chenzhjie/F1C200S-HomeAssistant-Board/README.md

# F1C200S-HomeAssistant-Board

这是一个 F1C200S 的 Linux 开发板。
