chenzhjie/F1C200S-HomeAssistant-Board/F1C200S-HomeAssistant-Board/case/top.STEP

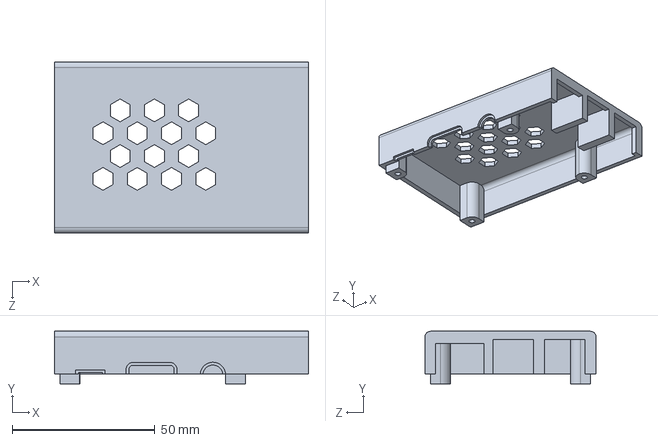
[picture p1: CAD file, 2022-08-28]
F1C200S-HomeAssistant-Board/case/top.STEP
89.0 x 18.4 x 60.0 mm
