chenzhjie/F1C200S-HomeAssistant-Board/F1C200S-HomeAssistant-Board/model/USB_type_C_smd.stp

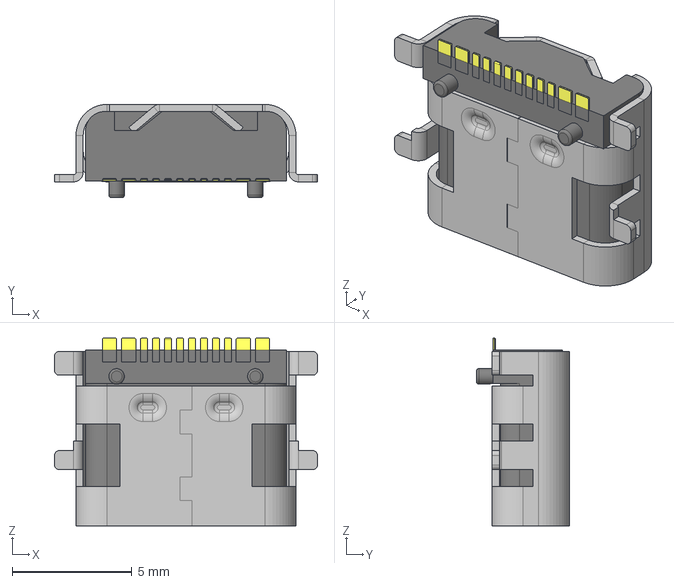
[picture p2: CAD file, 2022-08-28]
F1C200S-HomeAssistant-Board/model/USB_type_C_smd.stp
11.0 x 3.90 x 7.85 mm
