chenzhjie/F1C200S-HomeAssistant-Board/F1C200S-HomeAssistant-Board/case/bottom.STEP

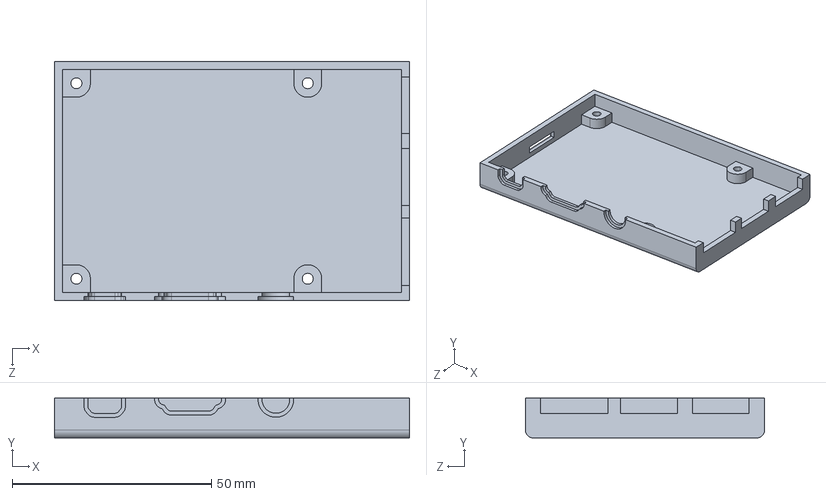
[picture p3: CAD file, 2022-08-28]
F1C200S-HomeAssistant-Board/case/bottom.STEP
89.0 x 10.0 x 60.0 mm
