chenzhjie/F1C200S-HomeAssistant-Board/F1C200S-HomeAssistant-Board/F1C200S-HomeAssistant-Board.kicad_pcb

## KiCad design F1C200S-HomeAssistant-Board/F1C200S-HomeAssistant-Board.kicad_pcb (2022-09-03)

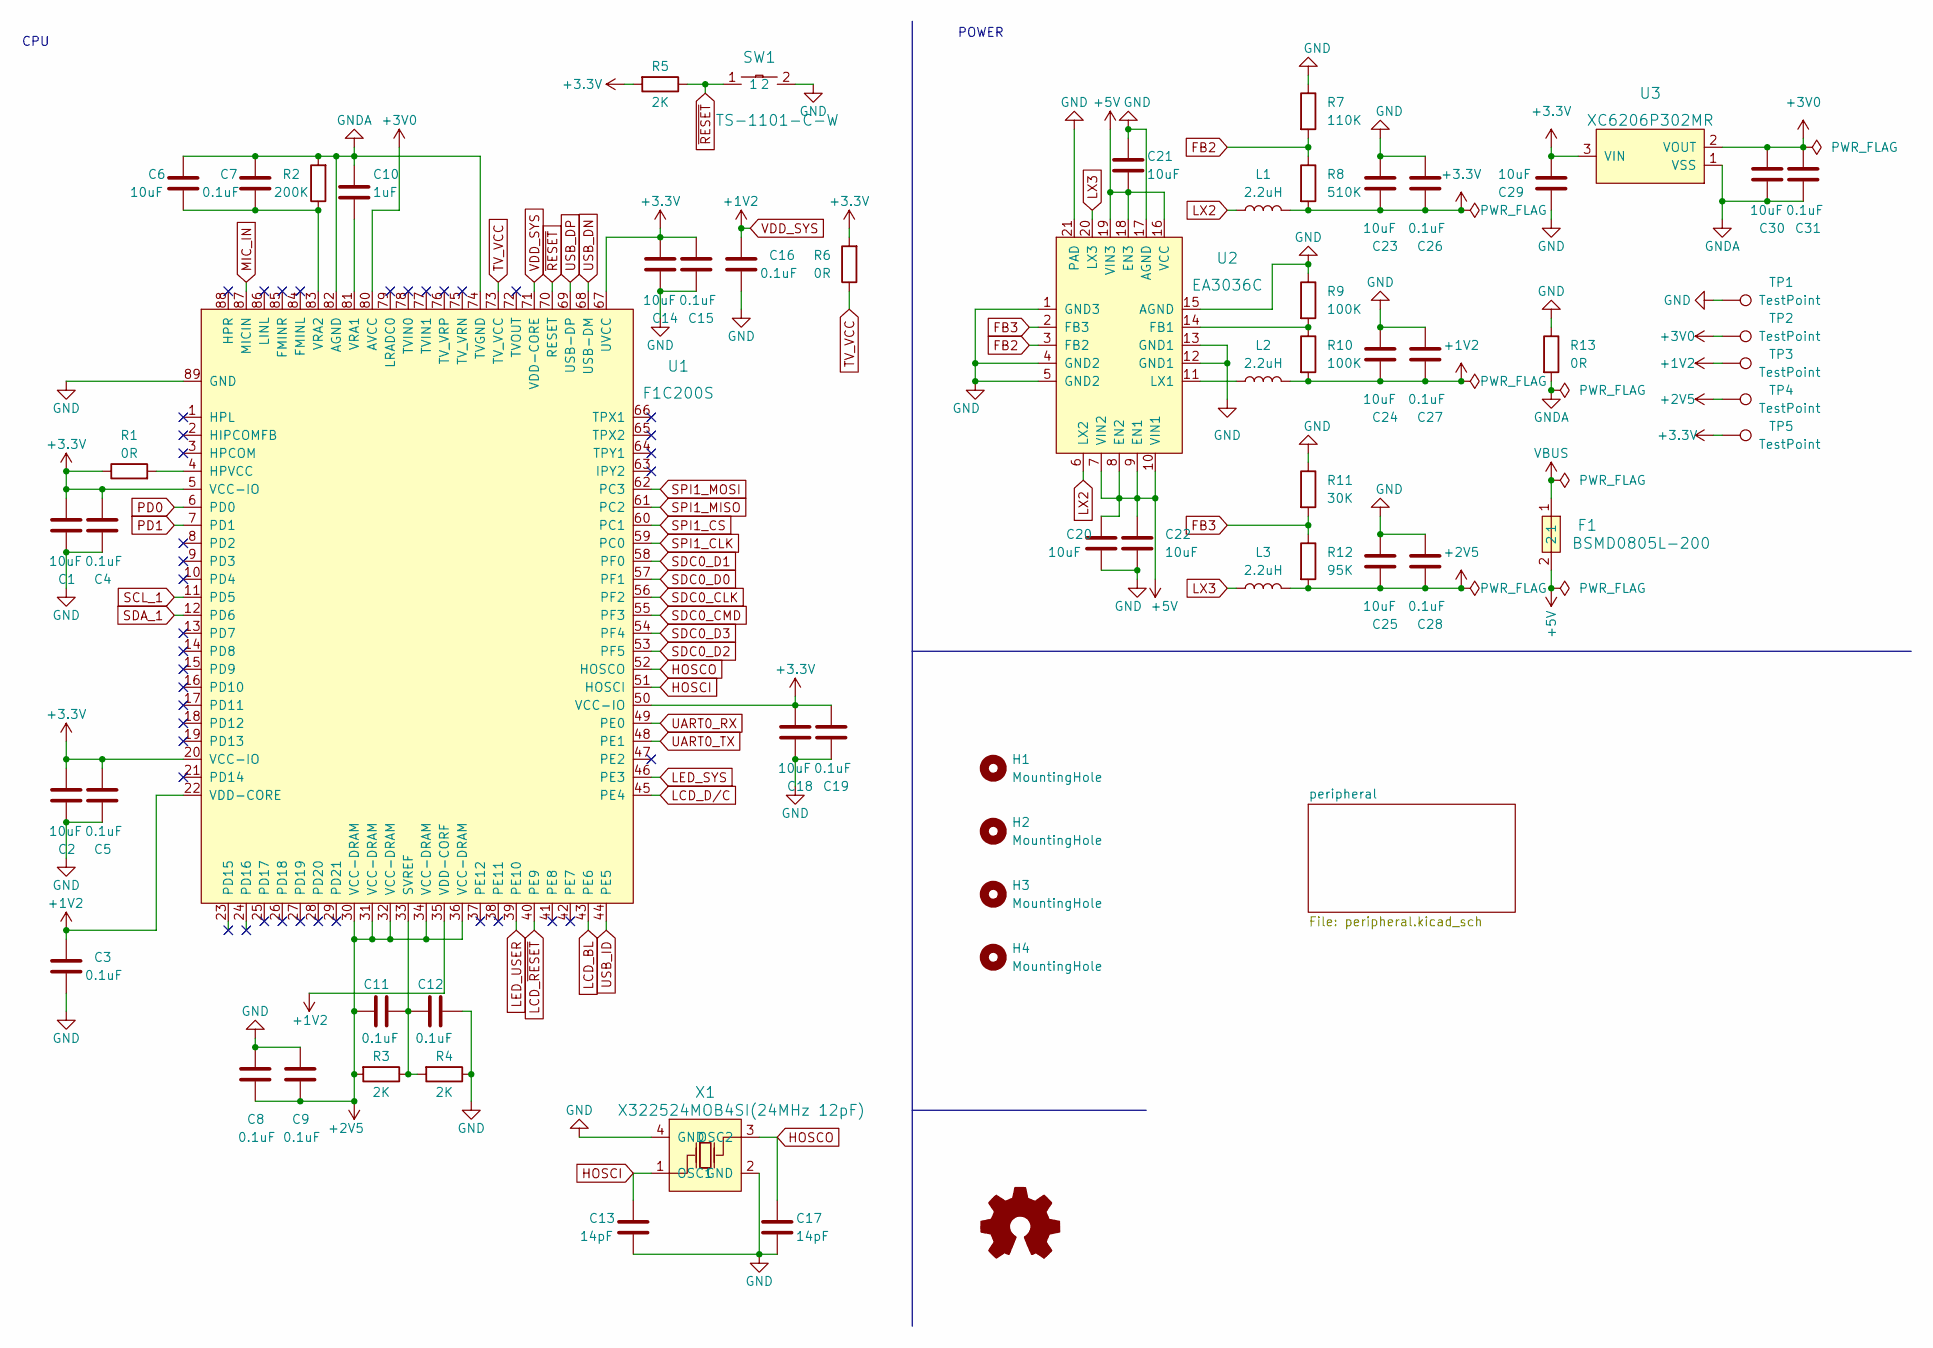
[picture p4: schematic F1C200S-HomeAssistant-Board.kicad_sch]

Parts:
C1, C2, C6, C14, C18, C20, C21, C22, C23, C24, C25, C29, C30: 10uF; C_0402_1005Metric_Pad0.74x0.62mm_HandSolder; LCSC Part C15525
C3, C4, C5, C7, C8, C9, C11, C12, C15, C16, C19, C26, C27, C28, C31: 0.1uF; C_0402_1005Metric_Pad0.74x0.62mm_HandSolder; LCSC Part C60474
C10: 1uF; C_0402_1005Metric_Pad0.74x0.62mm_HandSolder; LCSC Part C107372
C13, C17: 14pF; C_0402_1005Metric_Pad0.74x0.62mm_HandSolder; LCSC Part C3037644
F1: BSMD0805L-200; F0805; LCSC Part C2757931
H1, H2, H3, H4: MountingHole; MountingHole_2.7mm_M2.5
L1, L2, L3: 2.2uH; L0603; LCSC Part C394950
R1, R6, R13: 0R; R_0402_1005Metric_Pad0.72x0.64mm_HandSolder; LCSC Part C21376
R2: 200K; R_0402_1005Metric_Pad0.72x0.64mm_HandSolder; LCSC Part C114763
R3, R4, R5: 2K; R_0402_1005Metric_Pad0.72x0.64mm_HandSolder; LCSC Part C60488
R7: 110K; R_0402_1005Metric_Pad0.72x0.64mm_HandSolder; LCSC Part C138065
R8: 510K; R_0402_1005Metric_Pad0.72x0.64mm_HandSolder; LCSC Part C137961
R9, R10: 100K; R_0402_1005Metric_Pad0.72x0.64mm_HandSolder; LCSC Part C60491
R11: 30K; R_0402_1005Metric_Pad0.72x0.64mm_HandSolder; LCSC Part C138008
R12: 95K; R_0402_1005Metric_Pad0.72x0.64mm_HandSolder
SW1: TS-1101-C-W; SW-SMD_L6.0-W3.3-LS8.0; LCSC Part C318938
TP1, TP2, TP3, TP4, TP5: TestPoint; TestPoint_Pad_D1.0mm
U1: F1C200S; QFN-88_L10.0-W10.0-P0.40-BL-EP6.75; LCSC Part C2879851
U2: EA3036C; WQFN-20_L3.0-W3.0-P0.40-BL-EP; LCSC Part C570857
U3: XC6206P302MR; SOT-23-3L_L2.9-W1.6-P1.90-LS2.8-BL; LCSC Part C2904833
X1: X322524MOB4SI(24MHz 12pF); CRYSTAL-SMD_4P-L3.2-W2.5-BL; LCSC Part C70590

Connections:
+2V5: C8.2, C9.2, C11.1, C25.2, C28.2, L3.2, R3.2, R12.2, TP4.1, U1.30 (VCC-DRAM), U1.31 (VCC-DRAM), U1.32 (VCC-DRAM), U1.34 (VCC-DRAM), U1.36 (VCC-DRAM)
+3V0: C30.1, C31.1, TP2.1, U1.80 (AVCC), U3.2 (VOUT); also elsewhere on the board
+5V: C20.1, C21.1, C22.1, F1.2, U2.7 (VIN2), U2.8 (EN2), U2.9 (EN1), U2.10 (VIN1), U2.16 (VCC), U2.18 (EN3), U2.19 (VIN3); also elsewhere on the board
FB2: R7.2, R8.1, U2.3 (FB2)
FB3: R11.2, R12.1, U2.2 (FB3)
GND: C1.2, C2.2, C3.2, C4.2, C5.2, C8.1, C9.1, C12.2, C13.2, C14.2, C15.2, C16.2, C17.2, C18.2, C19.2, C20.2, C21.2, C22.2, C23.1, C24.1, C25.1, C26.1, C27.1, C28.1, C29.2, R4.1, R7.1, R9.1, R11.1, R13.1, SW1.2, TP1.1, U1.89 (GND), U2.1 (GND3), U2.4 (GND2), U2.5 (GND2), U2.12 (GND1), U2.13 (GND1), U2.15 (AGND), U2.17 (AGND), U2.21 (PAD), X1.2 (GND), X1.4 (GND); also elsewhere on the board
GNDA: C6.1, C7.1, C10.1, C30.2, C31.2, R2.2, R13.2, U1.74 (TVGND), U1.82 (AGND), U3.1 (VSS); also elsewhere on the board
HOSCI: C13.1, U1.51 (HOSCI), X1.1 (OSC1)
HOSCO: C17.1, U1.52 (HOSCO), X1.3 (OSC2)
LCD_BL: U1.43 (PE6); also elsewhere on the board
LCD_D/C: U1.45 (PE4); also elsewhere on the board
LCD_~RESET: U1.40 (PE9); also elsewhere on the board
LED_SYS: U1.46 (PE3); also elsewhere on the board
LED_USER: U1.39 (PE10); also elsewhere on the board
LX2: L1.1, U2.6 (LX2)
LX3: L3.1, U2.20 (LX3)
MIC_IN: U1.87 (MICIN); also elsewhere on the board
unnamed: C6.2, C7.2, R2.1, U1.83 (VRA2)
unnamed: C10.2, U1.81 (VRA1)
unnamed: C11.2, C12.1, R3.1, R4.2, U1.33 (SVREF)
unnamed: L2.1, U2.11 (LX1)
unnamed: R1.2, U1.4 (HPVCC)
unnamed: R9.2, R10.1, U2.14 (FB1)
PD0: U1.6 (PD0); also elsewhere on the board
PD1: U1.7 (PD1); also elsewhere on the board
SCL_1: U1.11 (PD5); also elsewhere on the board
SDA_1: U1.12 (PD6); also elsewhere on the board
SDC0_CLK: U1.56 (PF2); also elsewhere on the board
SDC0_CMD: U1.55 (PF3); also elsewhere on the board
SDC0_D0: U1.57 (PF1); also elsewhere on the board
SDC0_D1: U1.58 (PF0); also elsewhere on the board
SDC0_D2: U1.53 (PF5); also elsewhere on the board
SDC0_D3: U1.54 (PF4); also elsewhere on the board
SPI1_CLK: U1.59 (PC0); also elsewhere on the board
SPI1_CS: U1.60 (PC1); also elsewhere on the board
SPI1_MISO: U1.61 (PC2); also elsewhere on the board
SPI1_MOSI: U1.62 (PC3); also elsewhere on the board
TV_VCC: R6.1, U1.73 (TV_VCC)
UART0_RX: U1.49 (PE0); also elsewhere on the board
UART0_TX: U1.48 (PE1); also elsewhere on the board
USB_DN: U1.68 (USB-DM); also elsewhere on the board
USB_DP: U1.69 (USB-DP); also elsewhere on the board
USB_ID: U1.44 (PE5); also elsewhere on the board
VBUS: F1.1; also elsewhere on the board
VDD_SYS: C3.1, C16.1, C24.2, C27.2, L2.2, R10.2, TP3.1, U1.22 (VDD-CORE), U1.35 (VDD-CORF), U1.71 (VDD-CORE)
~RESET: R5.1, SW1.1, U1.70 (RESET)

Notes on the sheet:
POWER
CPU

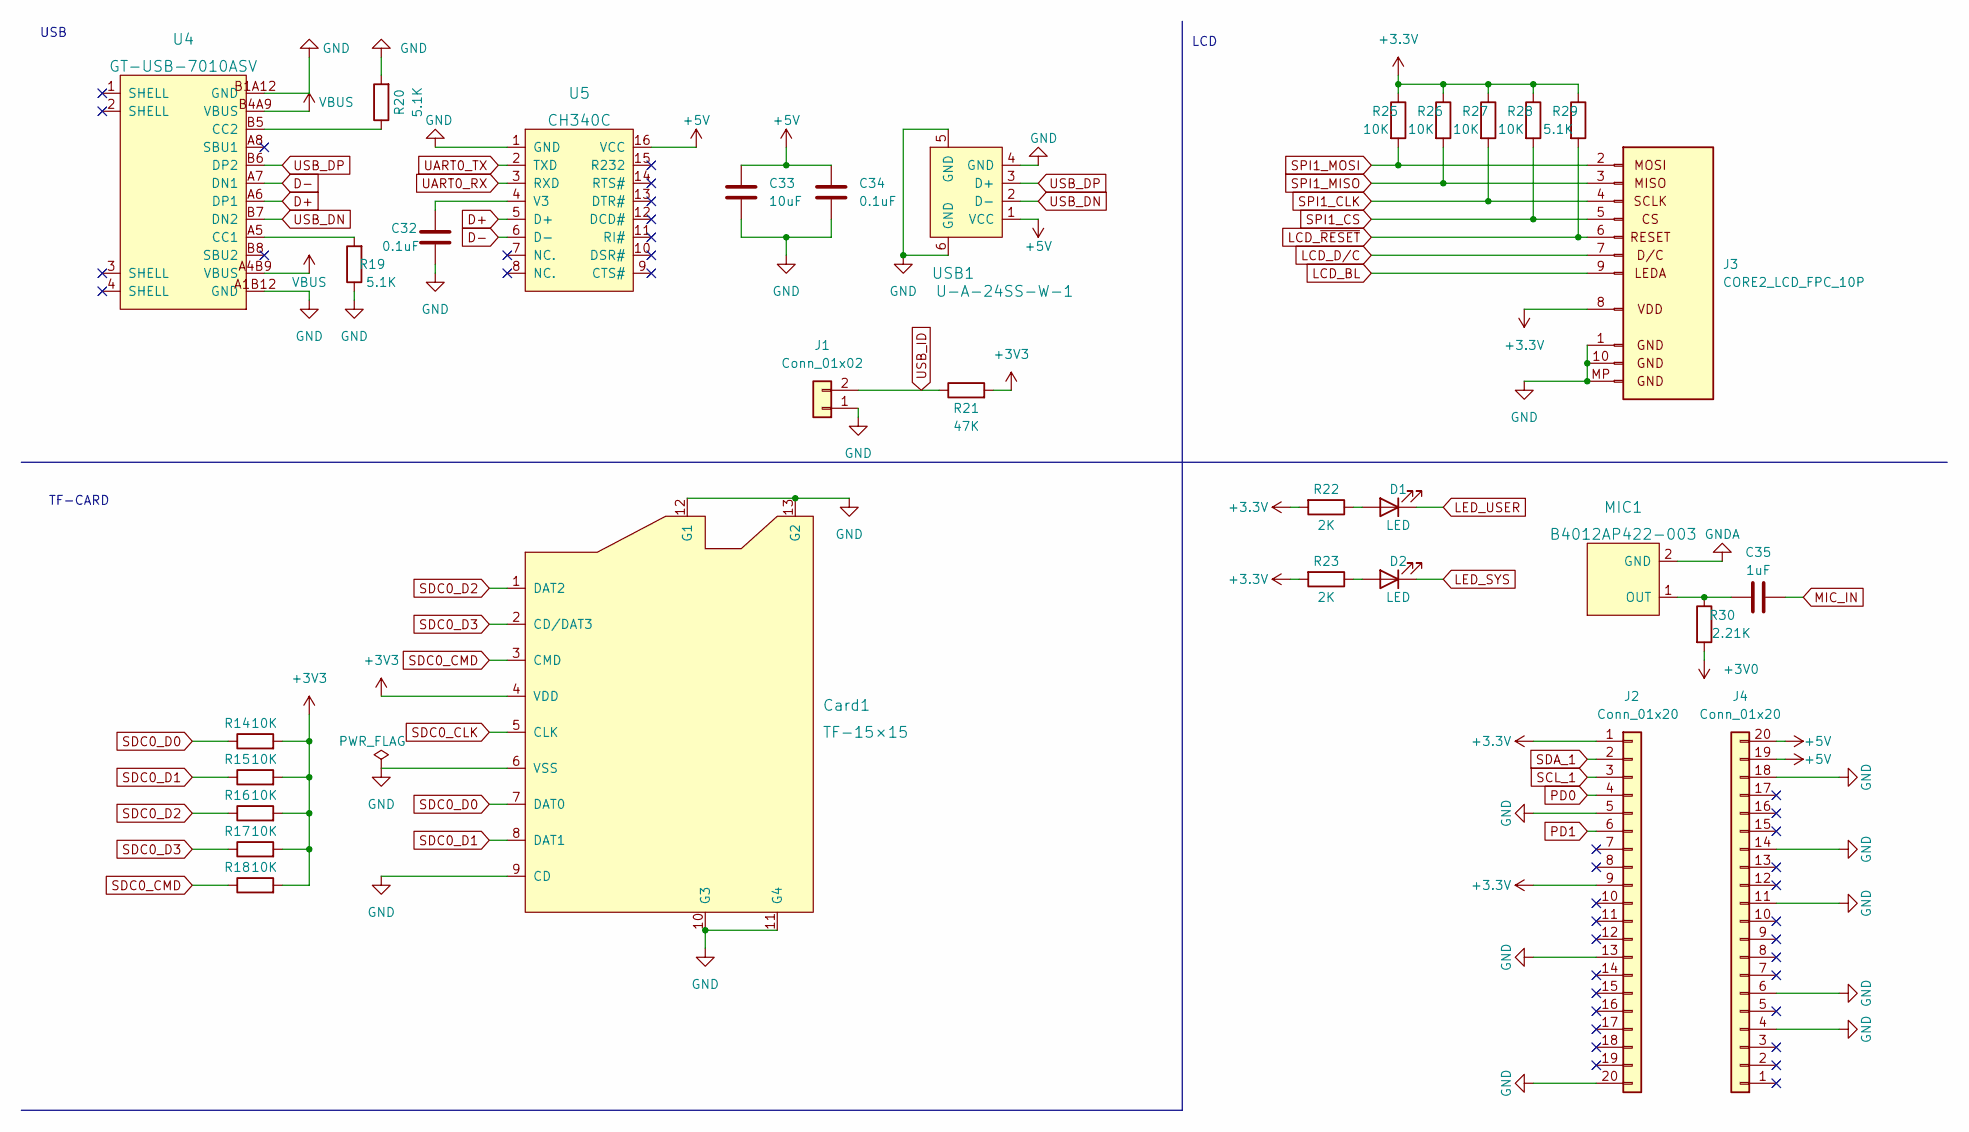
[picture p5: schematic peripheral.kicad_sch]

Parts:
C32, C34: 0.1uF; C_0402_1005Metric_Pad0.74x0.62mm_HandSolder; LCSC Part C60474
C33: 10uF; C_0402_1005Metric_Pad0.74x0.62mm_HandSolder; LCSC Part C15525
C35: 1uF; C_0402_1005Metric_Pad0.74x0.62mm_HandSolder; LCSC Part C107372
Card1: TF-15×15; TF-SMD_TF-15-15; LCSC Part C111196
D1: LED; LED_0402_1005Metric_Pad0.77x0.64mm_HandSolder; LCSC Part C434446
D2: LED; LED_0402_1005Metric_Pad0.77x0.64mm_HandSolder; LCSC Part C71911
J1: Conn_01x02; PinHeader_1x02_P2.54mm_Vertical
J2, J4: Conn_01x20; PinHeader_1x20_P2.54mm_Vertical
J3: CORE2_LCD_FPC_10P; TE_1-1734839-0_1x10-1MP_P0.5mm_Horizontal
MIC1: B4012AP422-003; MIC-TH_BD4.0-P1.40-D0.3-L; LCSC Part C233791
R14, R15, R16, R17, R18, R25, R26, R27, R28: 10K; R_0402_1005Metric_Pad0.72x0.64mm_HandSolder; LCSC Part C144807
R19, R20, R29: 5.1K; R_0402_1005Metric_Pad0.72x0.64mm_HandSolder; LCSC Part C105872
R21: 47K; R_0402_1005Metric_Pad0.72x0.64mm_HandSolder; LCSC Part C144757
R22, R23: 2K; R_0402_1005Metric_Pad0.72x0.64mm_HandSolder; LCSC Part C60488
R30: 2.21K; R_0402_1005Metric_Pad0.72x0.64mm_HandSolder; LCSC Part C416375
U4: GT-USB-7010ASV; USB-C-SMD_G-SWITCH_GT-USB-7010ASV; LCSC Part C2988369
U5: CH340C; SOP-16_L10.0-W3.9-P1.27-LS6.0-BL; LCSC Part C84681
USB1: U-A-24SS-W-1; USB-A-SMD_U-A-24SS-W-1; LCSC Part C283549

Connections:
+3V0: R30.2; also elsewhere on the board
+5V: C33.1, C34.1, J4.19, J4.20, U5.16 (VCC), USB1.1 (VCC); also elsewhere on the board
D+: U4.A6 (DP1), U5.5 (D+)
D-: U4.A7 (DN1), U5.6 (D-)
GND: C32.2, C33.2, C34.2, Card1.6 (VSS), Card1.9 (CD), Card1.10 (G3), Card1.11 (G4), Card1.12 (G1), Card1.13 (G2), J1.1, J2.5, J2.13, J2.20, J3.1, J3.10, J3.MP (Pin_10), J4.4, J4.6, J4.11, J4.14, J4.18, R19.1, R20.2, U4.A1B12 (GND), U4.B1A12 (GND), U5.1 (GND), USB1.4 (GND), USB1.5 (GND), USB1.6 (GND); also elsewhere on the board
GNDA: MIC1.2 (GND); also elsewhere on the board
LCD_BL: J3.9; also elsewhere on the board
LCD_D/C: J3.7; also elsewhere on the board
LCD_~RESET: J3.6, R29.2; also elsewhere on the board
LED_SYS: D2.1 (K); also elsewhere on the board
LED_USER: D1.1 (K); also elsewhere on the board
MIC_IN: C35.2; also elsewhere on the board
unnamed: C32.1, U5.4 (V3)
unnamed: C35.1, MIC1.1 (OUT), R30.1
unnamed: D1.2 (A), R22.1
unnamed: D2.2 (A), R23.1
unnamed: R19.2, U4.A5 (CC1)
unnamed: R20.1, U4.B5 (CC2)
PD0: J2.4; also elsewhere on the board
PD1: J2.6; also elsewhere on the board
SCL_1: J2.3; also elsewhere on the board
SDA_1: J2.2; also elsewhere on the board
SDC0_CLK: Card1.5 (CLK); also elsewhere on the board
SDC0_CMD: Card1.3 (CMD), R18.1; also elsewhere on the board
SDC0_D0: Card1.7 (DAT0), R14.1; also elsewhere on the board
SDC0_D1: Card1.8 (DAT1), R15.1; also elsewhere on the board
SDC0_D2: Card1.1 (DAT2), R16.1; also elsewhere on the board
SDC0_D3: Card1.2 (CD/DAT3), R17.1; also elsewhere on the board
SPI1_CLK: J3.4, R27.2; also elsewhere on the board
SPI1_CS: J3.5, R28.2; also elsewhere on the board
SPI1_MISO: J3.3, R26.2; also elsewhere on the board
SPI1_MOSI: J3.2, R25.2; also elsewhere on the board
UART0_RX: U5.3 (RXD); also elsewhere on the board
UART0_TX: U5.2 (TXD); also elsewhere on the board
USB_DN: U4.B7 (DN2), USB1.2 (D-); also elsewhere on the board
USB_DP: U4.B6 (DP2), USB1.3 (D+); also elsewhere on the board
USB_ID: J1.2, R21.1; also elsewhere on the board
VBUS: U4.A4B9 (VBUS), U4.B4A9 (VBUS); also elsewhere on the board

Notes on the sheet:
LCD
TF-CARD
USB

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
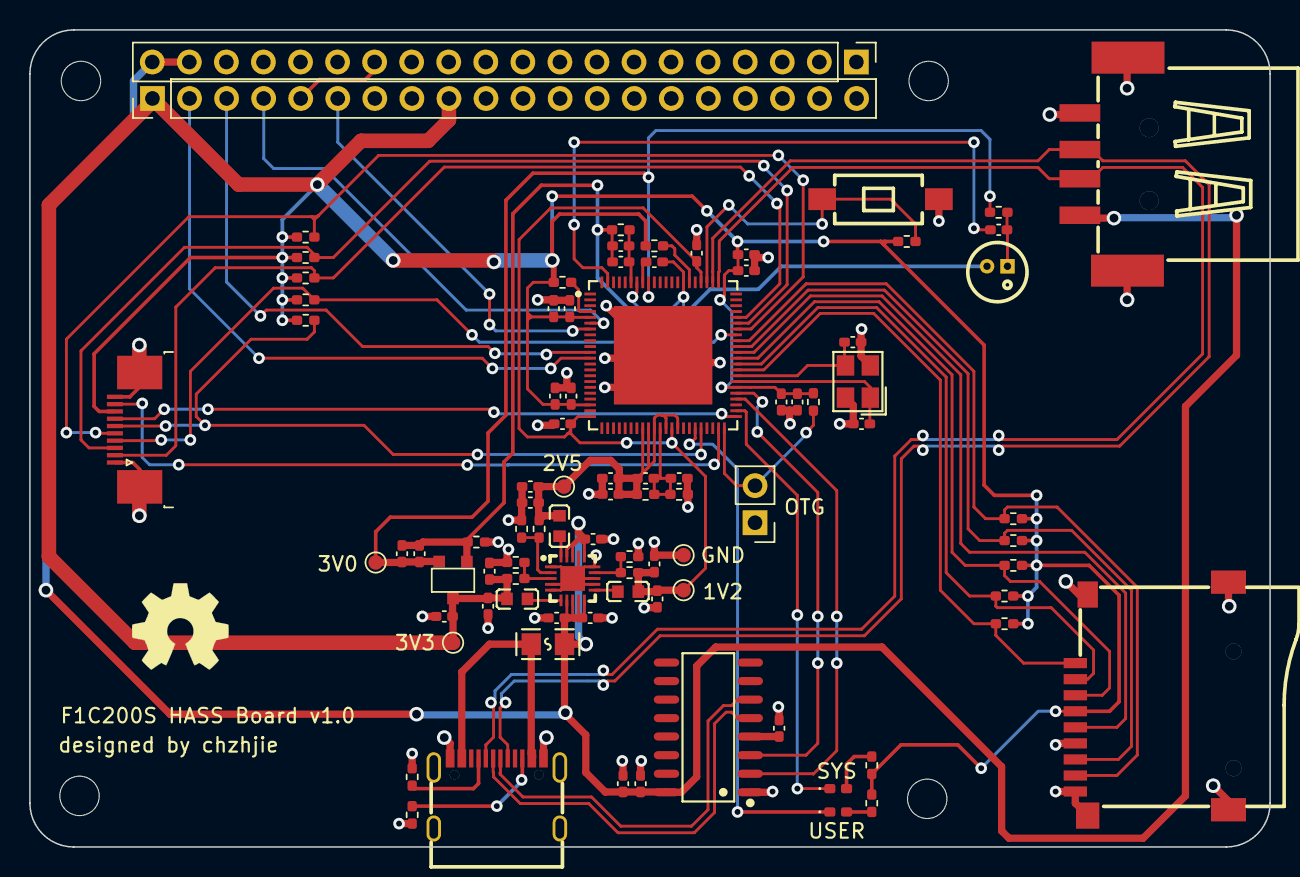
[picture p6: board F1C200S-HomeAssistant-Board.kicad_pcb from above]

Board: 2 copper layers, 85.0 x 56.0 mm, 93 parts (0 on the bottom side), 55 nets.
