chenzhjie/F1C200S-HomeAssistant-Board/(commit log)

2022-09-03 docs: 更新制作文件
    [F1C200S-HomeAssistant-Board-B_Cu.gbr, F1C200S-HomeAssistant-Board-B_Mask.gbr, F1C200S-HomeAssistant-Board-B_Paste.gbr, F1C200S-HomeAssistant-Board-B_Silkscreen.gbr, F1C200S-HomeAssistant-Board-Edge_Cuts.gbr, F1C200S-HomeAssistant-Board-F_Cu.gbr, F1C200S-HomeAssistant-Board-F_Mask.gbr, F1C200S-HomeAssistant-Board-F_Paste.gbr]
2022-09-04 docs: BOM 表修正
    [F1C200S-HomeAssistant-Board.csv]
2022-09-04 docs: 更新 BOM 表
    [F1C200S-HomeAssistant-Board.csv]
